hennedo/wifitally/(list of files, drawings)

Other design files:
hardware/PCB_35x35mmFinalPoured.dip
hardware/tally.dch
hardware/tally.dip
