hennedo/wifitally/(threads)

Thread 1 (2017-12-28):

Using ESP8266 for transmitter as well

bleightyturner, 2017-12-28:
I know you mentioned the atem needing a stable connection. Was just curious if you’d tried using a ESP8266 for the sender as well and whether that didn’t work as well. Thanks.

henne-, 2018-05-08:
Hey! Sorry for the late reply.
Until now I didn't test the esp8266 as transmitter. But since I got new accesspoints, at least the ATEM software on my mac seems to be working stable via WiFi. I got an unused ESP32 board here and will try that.

But keep in mind, even if it works with my accesspoints, that doesn't mean it's working with every wireless access point.

bleightyturner, 2018-05-09:
Makes sense. Thanks

Closed 2022-02-18.

Thread 3 (2020-10-12):

Multiple tally receivers?

DVEntertainment, 2020-10-12:
Hi!
Does this project support multiple receivers?

Lets say i have camera's with operators on input 4, 5 and 6. Can i send transmit all tallys with one ardiuno, and receive with 3 esp's?

I have knowledge of arduino, so i can understand your code.

best regards, Daniël

hennedo, 2020-10-16:
Hey Daniël,
yes! The codebase supports up to 8 input tally signals and an unlimited number of esp's receiving them.

Closed 2022-02-18.
