hennedo/wifitally/(commit log)

2015-06-15 updated sourcecode to boardlayout, added dipswitch id selection
2015-06-15 added board, (do not use this one tough)
    [Wifi_Tally.dip]
2015-11-10 fixed some bugs, less network usage, standalone for tally: simply connect to wifitally network and use the soon comeing iphone app
    [Wifi_Tally.dip]
2016-06-21 working shit
    [ShopCart.csv, Wifi_Tally.dip, tally.dch, tally.dip]
2016-07-07 Fixed the missing trace on the charging chip
    [PCB_35x35mmFinalPoured.dip]
